ttahsin-bey/TapeCart-PC-Adapter/README.md

# TapeCart PC-Adapter
USB-Adapter to connect your TapeCart directly to your PC

Current Design:

Rendering
