ttahsin-bey/TapeCart-PC-Adapter/Circuit Diagram - TapeCart_PC-Adapter.pdf

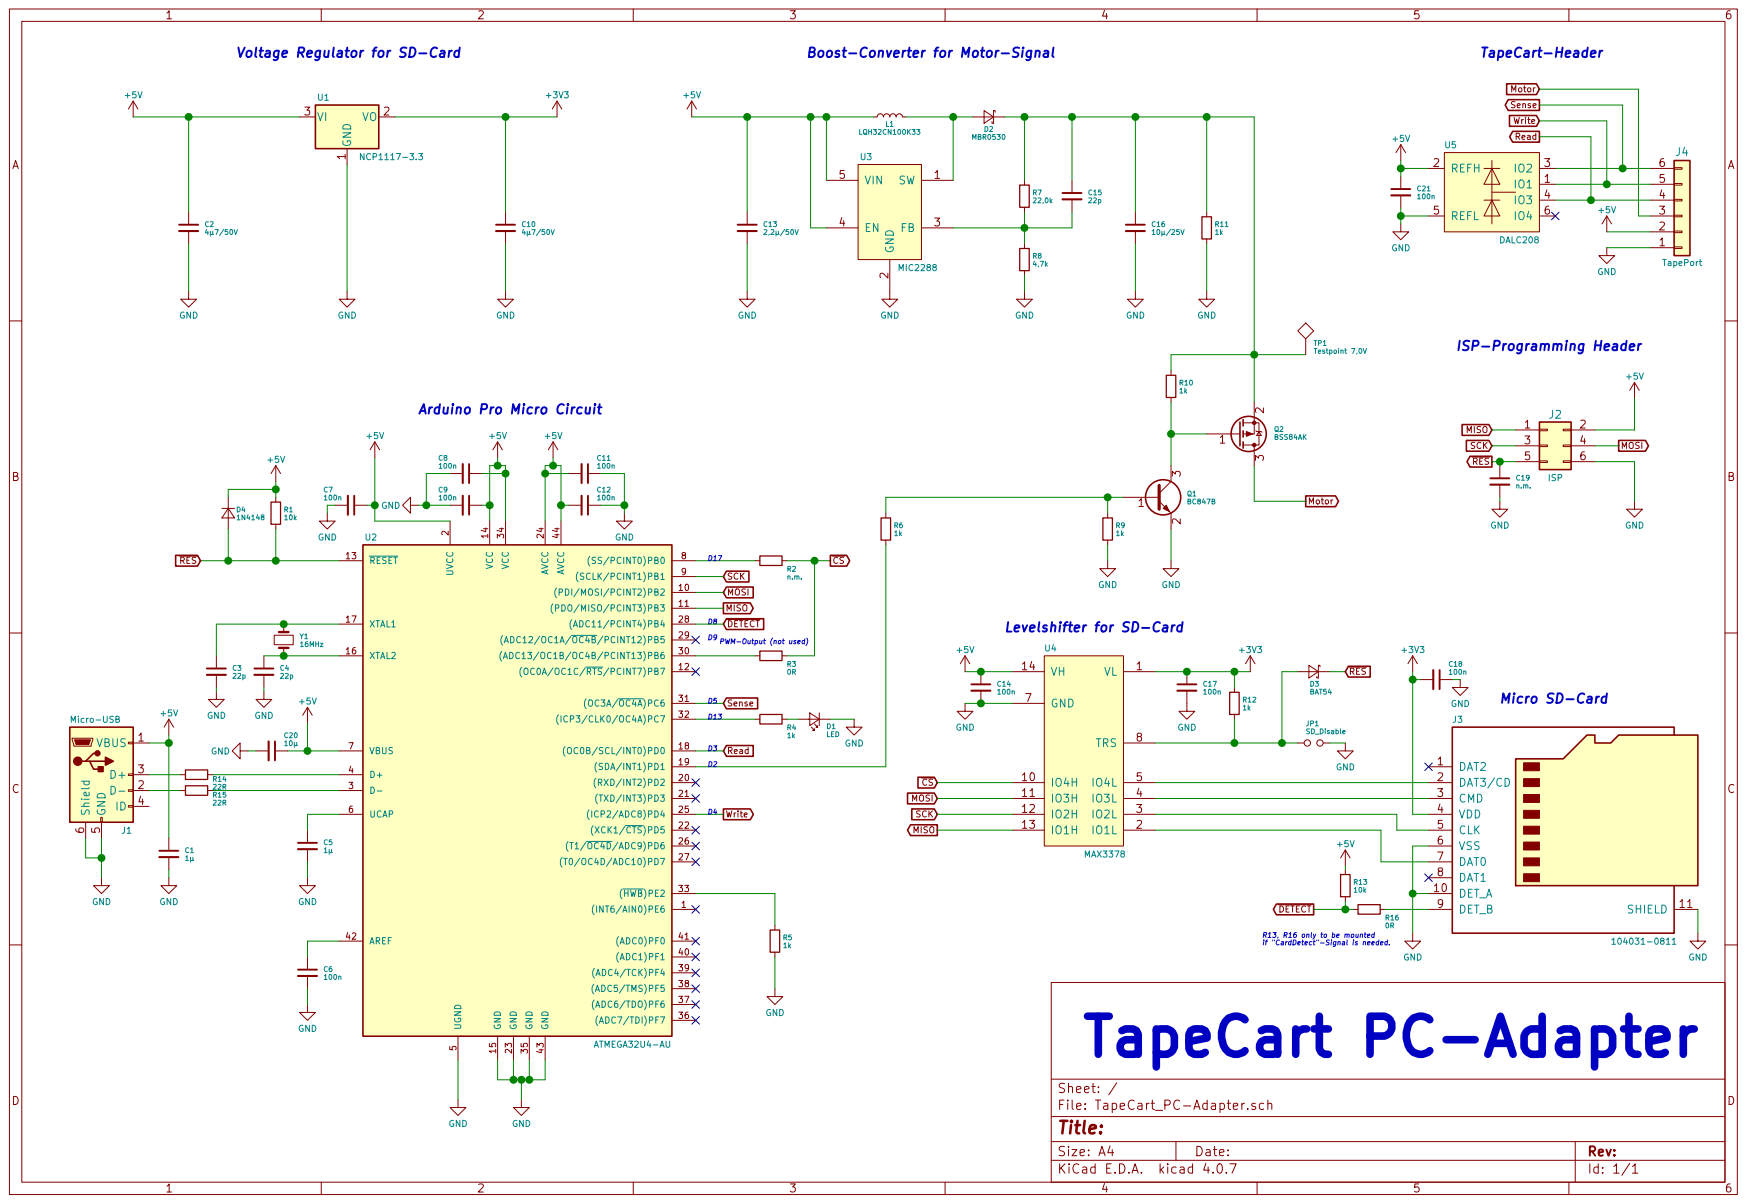
[picture p1: page 1]
