ttahsin-bey/TapeCart-PC-Adapter/KiCad/TapeCart_PC-Adapter.kicad_pcb

## KiCad design KiCad/TapeCart_PC-Adapter.kicad_pcb (2018-10-08)

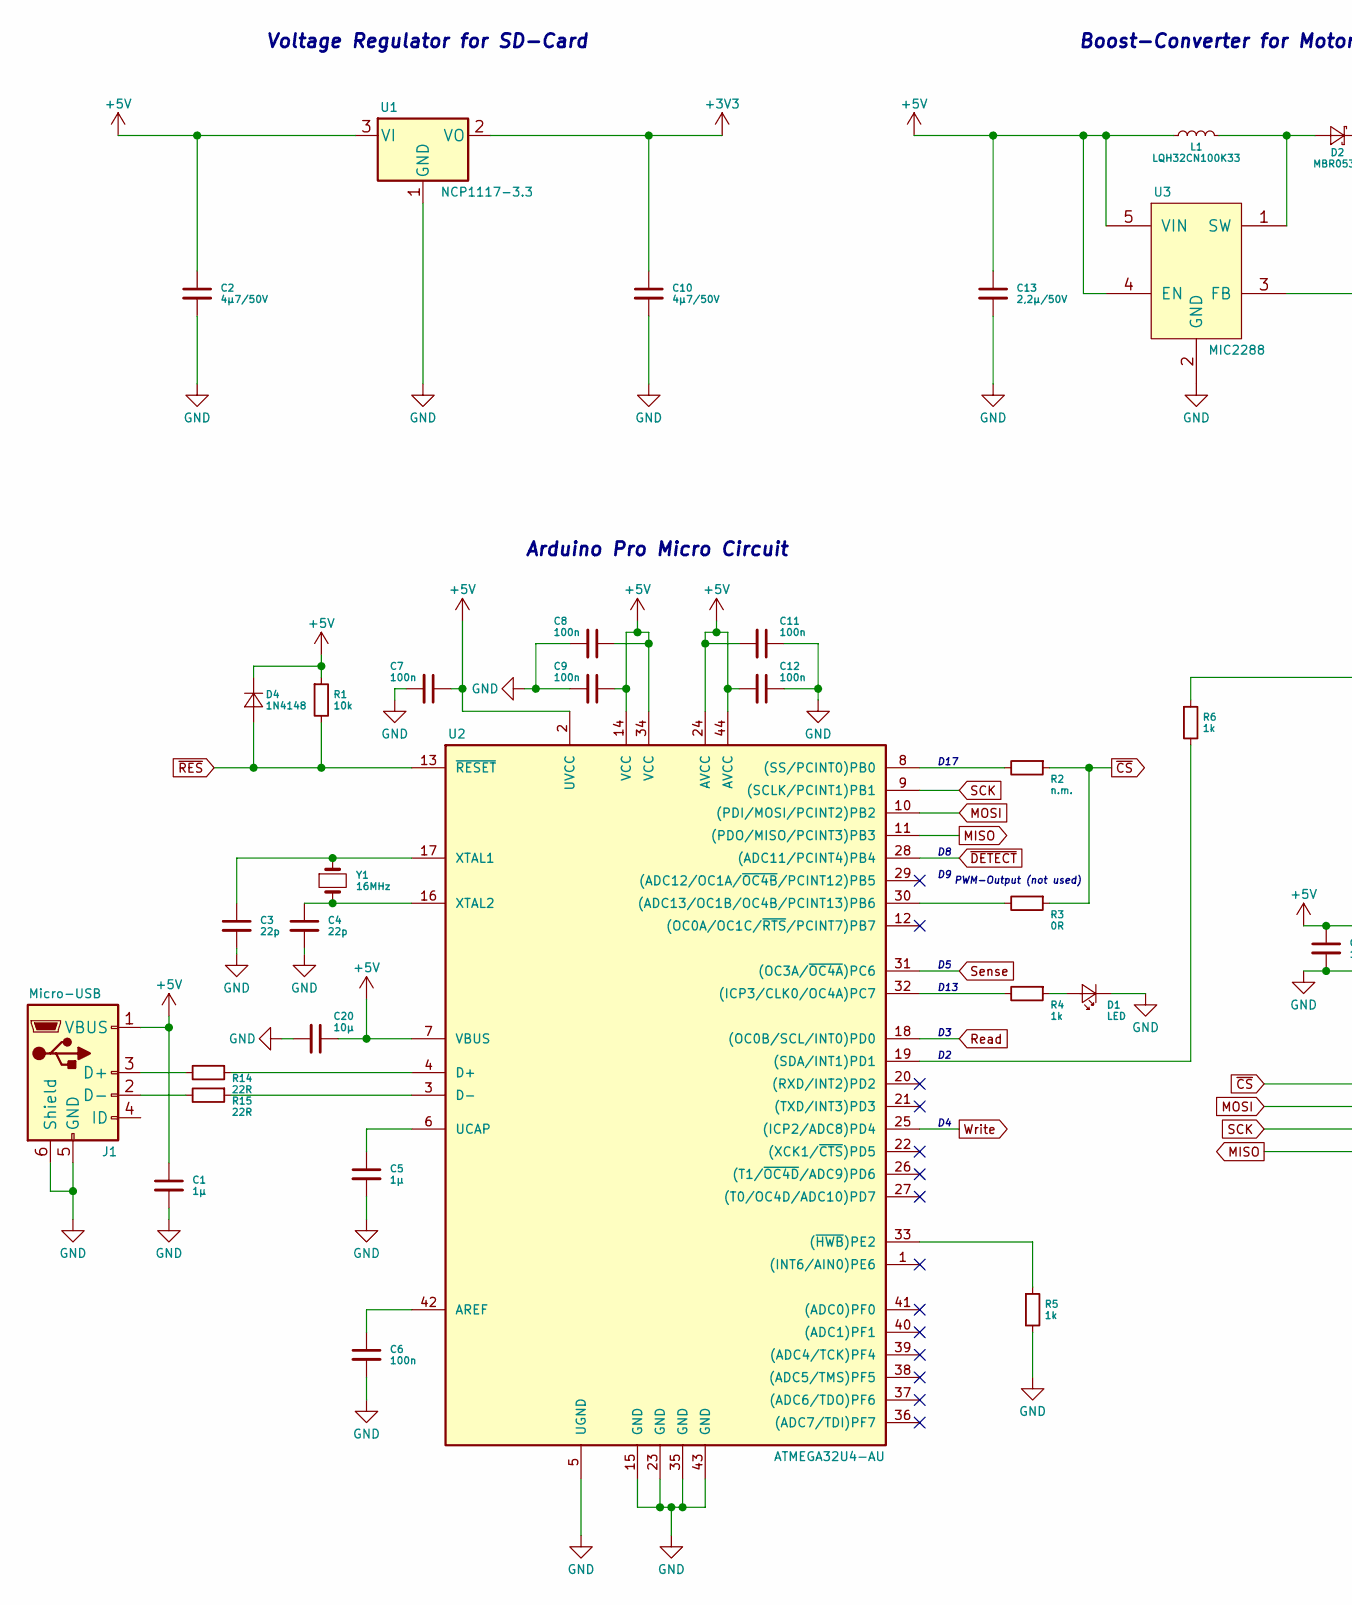
[picture p2: schematic TapeCart_PC-Adapter.sch, part in row 1, column 1]

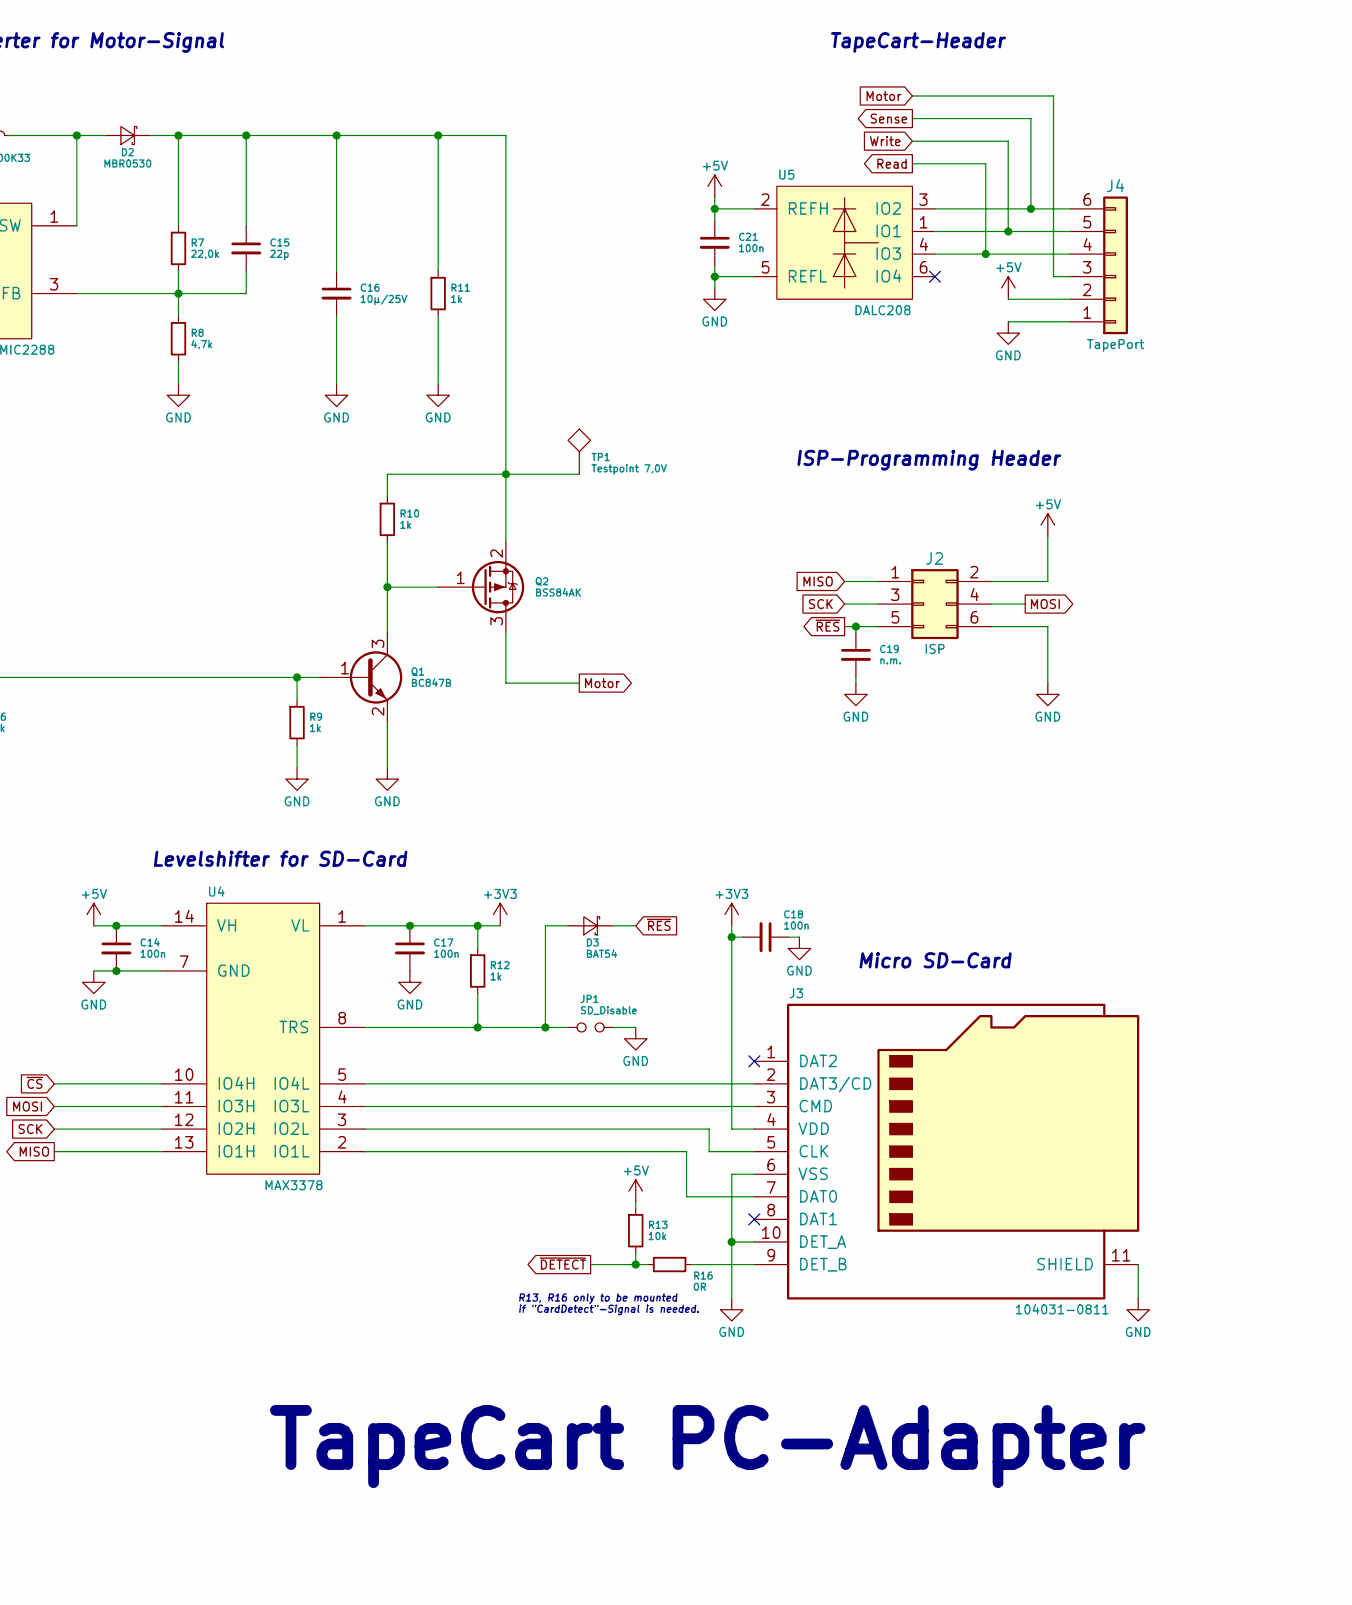
[picture p3: schematic TapeCart_PC-Adapter.sch, part in row 1, column 2]

Parts:
C1: 1µ; TTB_C1206
C2, C10: 4µ7/50V; TTB_C1206
C3, C4: 22p; TTB_C0603wide
C5: 1µ; TTB_C0805
C6, C7, C8, C9, C11, C12, C14, C17, C18, C21: 100n; TTB_C0603
C13: 2,2µ/50V; TTB_C1206
C15: 22p; TTB_C0603
C16: 10µ/25V; TTB_C1206
C19: n.m.; TTB_C0603
C20: 10µ; TTB_C0805
D1: LED; TTB_LED0805
D2: MBR0530; TTB_D_SOD-123; Digikey MBR0530CT-ND
D3: BAT54; TTB_SOT23; Digikey BAT54FSCT-ND
D4: 1N4148; TTB_D0603
J1: Micro-USB; TTB_USB-B_Micro_Würth
J2: ISP; TTB_Pinhead_2x3
J3: 104031-0811; TTB_MicroSD_1040310811; Digikey WM6357CT-ND
J4: TapePort; TTB_C64_Tapeport_PCB
JP1: SD_Disable; TTB_Pinhead_1x2
L1: LQH32CN100K33; TTB_L_MURATA-LQH32; Digikey 490-6614-1-ND
Q1: BC847B; TTB_SOT23; Digikey BC847BLT3GOSCT-ND
Q2: BSS84AK; TTB_SOT23; Digikey BSS84CT-ND
R1, R13: 10k; TTB_R0603
R2: n.m.; TTB_R0603
R3, R16: 0R; TTB_R0603
R4, R5, R6, R9, R10, R11, R12: 1k; TTB_R0603
R7: 22,0k; TTB_R0603
R8: 4,7k; TTB_R0603
R14, R15: 22R; TTB_R0603
TP1: Testpoint 7,0V; Measurement_Point_Round-SMD-Pad_Small
U1: NCP1117-3.3; SOT-223-3Lead_TabPin2
U2: ATMEGA32U4-AU; TQFP-44_10x10mm_Pitch0.8mm
U3: MIC2288; SOT-23-5_HandSoldering; Digikey 576-1729-1-ND
U4: MAX3378; TSSOP-14_4.4x5mm_Pitch0.65mm; Digikey MAX3378EEUD+-ND
U5: DALC208; TTB_SOT23-6L
Y1: 16MHz; TTB_7A

Connections:
+3V3: C10.1, C17.1, C18.2, J3.4 (VDD), R12.1, U1.2 (VO), U4.1 (VL)
+5V: C1.1, C2.1, C7.1, C8.1, C9.1, C11.2, C12.2, C13.1, C14.1, C20.1, C21.1, D4.1 (K), J1.1 (VBUS), J2.2, J4.2, L1.1, R1.1, R13.1, U1.3 (VI), U2.2 (UVCC), U2.7 (VBUS), U2.14 (VCC), U2.24 (AVCC), U2.34 (VCC), U2.44 (AVCC), U3.4 (EN), U3.5 (VIN), U4.14 (VH), U5.2 (REFH)
GND: C1.2, C2.2, C3.2, C4.2, C5.2, C6.2, C7.2, C8.2, C9.2, C10.2, C11.1, C12.1, C13.2, C14.2, C16.2, C17.2, C18.1, C19.2, C20.2, C21.2, D1.1 (K), J1.5 (GND), J1.6 (Shield), J2.6, J3.6 (VSS), J3.10 (DET_A), J3.11 (SHIELD), J4.1, JP1.2, Q1.2 (E), R5.2, R8.2, R9.2, R11.2, U1.1 (GND), U2.5 (UGND), U2.15 (GND), U2.23 (GND), U2.35 (GND), U2.43 (GND), U3.2 (GND), U4.7 (GND), U5.5 (REFL)
MISO: J2.1, U2.11 ((PDO/MISO/PCINT3)PB3), U4.13 (IO1H)
MOSI: J2.4, U2.10 ((PDI/MOSI/PCINT2)PB2), U4.11 (IO3H)
Motor: J4.3, Q2.3 (D)
unnamed: C3.1, U2.17 (XTAL1), Y1.1
unnamed: C4.1, U2.16 (XTAL2), Y1.2
unnamed: C5.1, U2.6 (UCAP)
unnamed: C6.1, U2.42 (AREF)
unnamed: C15.1, C16.1, D2.1 (K), Q2.2 (S), R7.1, R10.1, R11.1, TP1.1
unnamed: C15.2, R7.2, R8.1, U3.3 (FB)
unnamed: D1.2 (A), R4.1
unnamed: D2.2 (A), L1.2, U3.1 (SW)
unnamed: D3.2 (A), JP1.1, R12.2, U4.8 (TRS)
unnamed: J1.2 (D-), R15.2
unnamed: J1.3 (D+), R14.2
unnamed: J3.2 (DAT3/CD), U4.5 (IO4L)
unnamed: J3.3 (CMD), U4.4 (IO3L)
unnamed: J3.5 (CLK), U4.3 (IO2L)
unnamed: J3.7 (DAT0), U4.2 (IO1L)
unnamed: J3.9 (DET_B), R16.1
unnamed: Q1.1 (B), R6.1, R9.1
unnamed: Q1.3 (C), Q2.1 (G), R10.2
unnamed: R2.2, U2.8 ((SS/PCINT0)PB0)
unnamed: R3.2, U2.30 ((ADC13/OC1B/OC4B/PCINT13)PB6)
unnamed: R4.2, U2.32 ((ICP3/CLK0/OC4A)PC7)
unnamed: R5.1, U2.33 ((~HWB~)PE2)
unnamed: R6.2, U2.19 ((SDA/INT1)PD1)
unnamed: R14.1, U2.4 (D+)
unnamed: R15.1, U2.3 (D-)
Read: J4.4, U2.18 ((OC0B/SCL/INT0)PD0), U5.4 (IO3)
SCK: J2.3, U2.9 ((SCLK/PCINT1)PB1), U4.12 (IO2H)
Sense: J4.6, U2.31 ((OC3A/~OC4A~)PC6), U5.3 (IO2)
Write: J4.5, U2.25 ((ICP2/ADC8)PD4), U5.1 (IO1)
~CS: R2.1, R3.1, U4.10 (IO4H)
~DETECT: R13.2, R16.2, U2.28 ((ADC11/PCINT4)PB4)
~RES: C19.1, D3.1 (K), D4.2 (A), J2.5, R1.2, U2.13 (~RESET~)

Notes on the sheet:
TapeCart PC-Adapter
Voltage Regulator for SD-Card
Boost-Converter for Motor-Signal
ISP-Programming Header
Arduino Pro Micro Circuit
Levelshifter for SD-Card
TapeCart-Header
Micro SD-Card
D13
D17
PWM-Output (not used)
R13, R16 only to be mounted if "CardDetect"-Signal is needed.

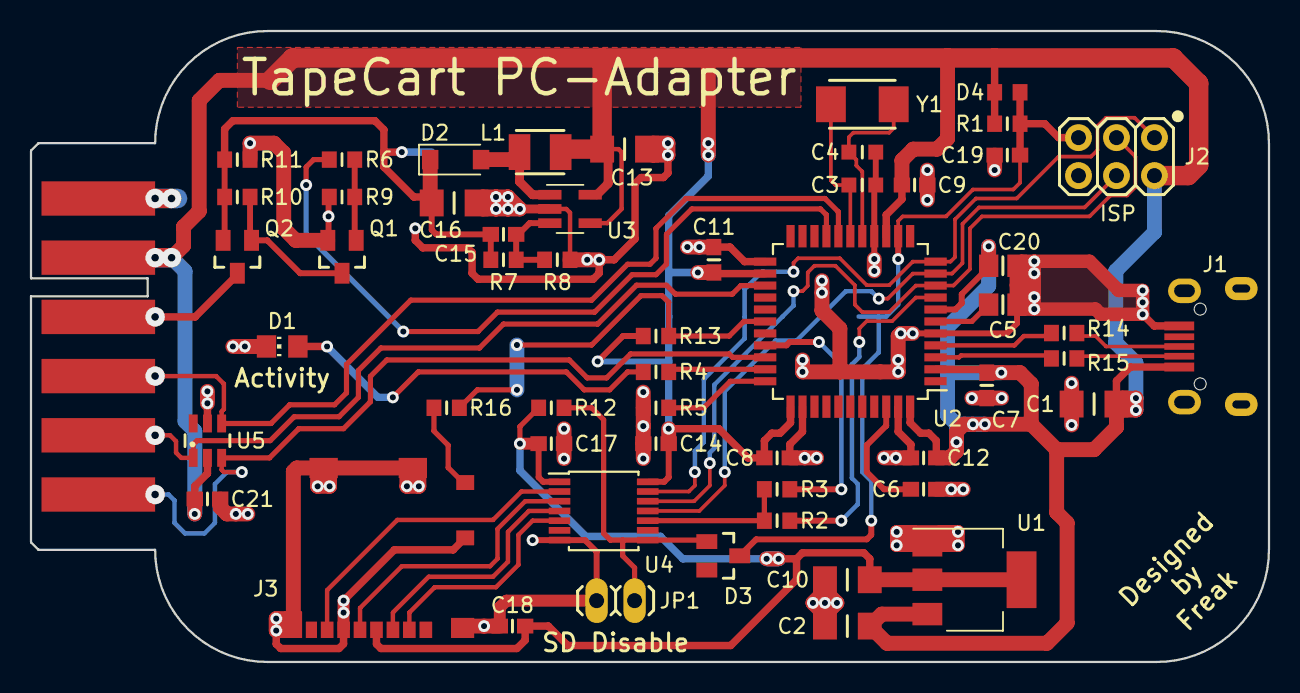
[picture p4: board TapeCart_PC-Adapter.kicad_pcb from above]

Board: 2 copper layers, 82.8 x 42.2 mm, 56 parts (1 on the bottom side), 38 nets.
