ttahsin-bey/TapeCart-PC-Adapter/(commit log)

2018-10-08 Circuit Diagram added
2018-10-08 KiCAD-Project added
    [TapeCart_PC-Adapter.kicad_pcb, TapeCart_PC-Adapter.sch]
2018-10-08 BOM added
